Srbija-Hakuje-Koronu/Room-sterilizer/Koristan materijal/94032886_10158607522339924_7840081783709237248_n.jpg

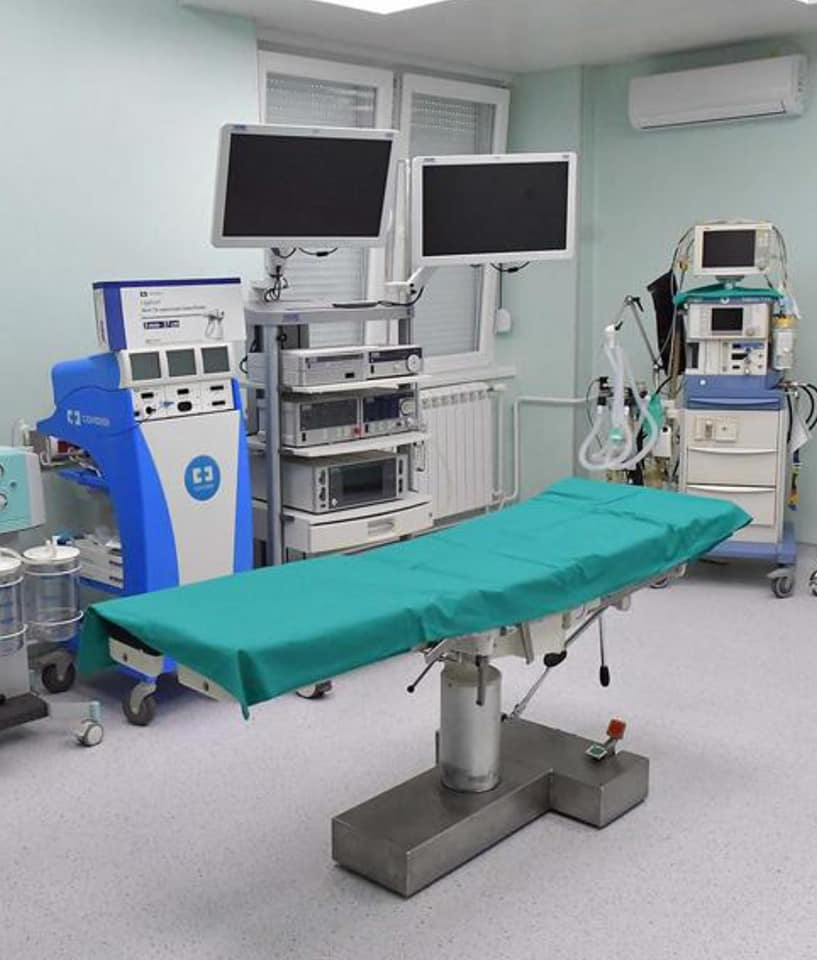
Koristan materijal/94032886_10158607522339924_7840081783709237248_n.jpg
