Srbija-Hakuje-Koronu/Room-sterilizer/Koristan materijal/93118392_10219294678612074_5420074201555927040_o.jpg

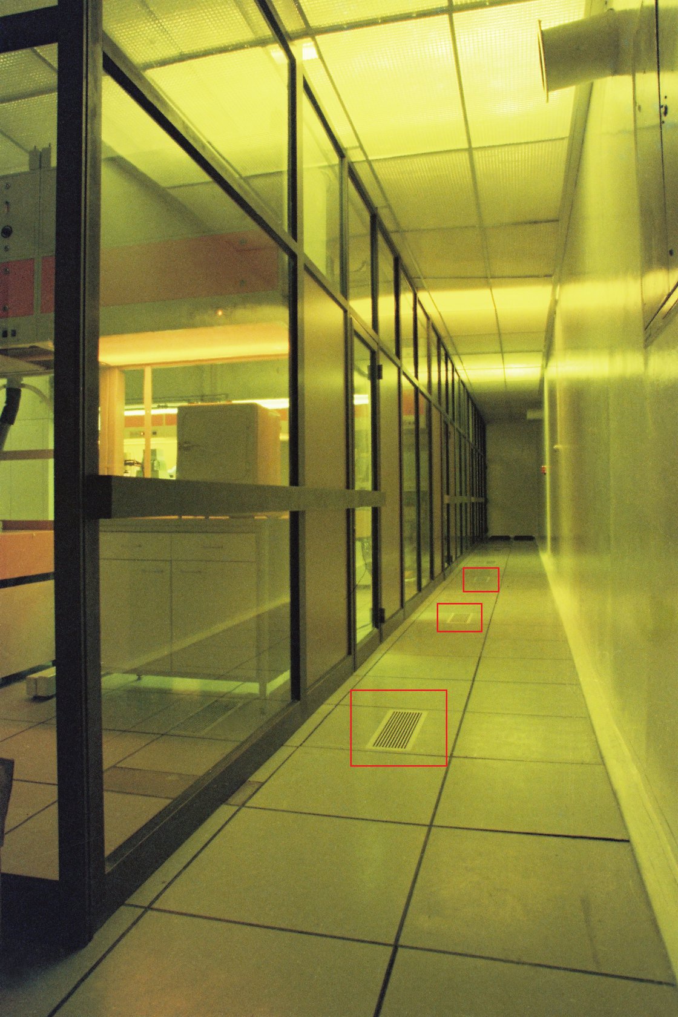
Koristan materijal/93118392_10219294678612074_5420074201555927040_o.jpg
