Srbija-Hakuje-Koronu/Room-sterilizer/Dokumentacija sa crtežima /1591692928066_Dokumentacija za izradu sterilizatora.docx

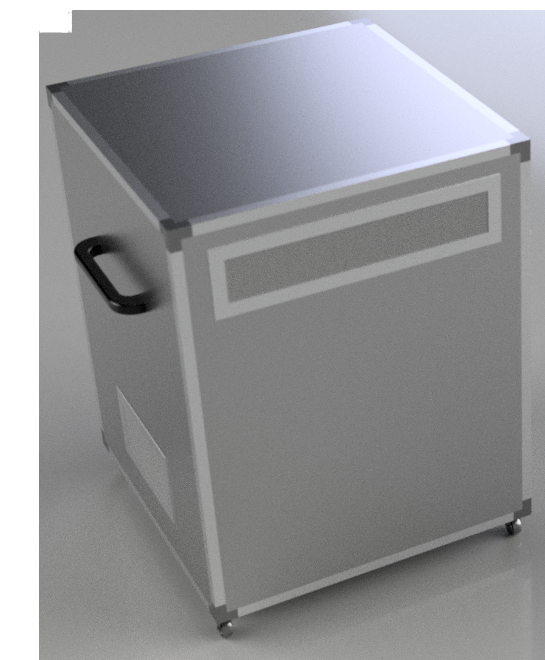
[picture p9: figure]

STERILIZATOR PROSTORIJA

Potreban Materijal:

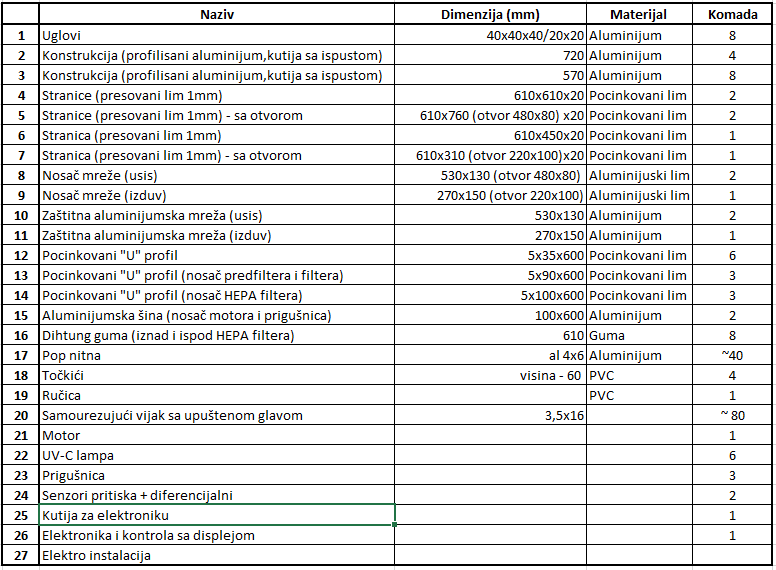
[picture p10: figure]
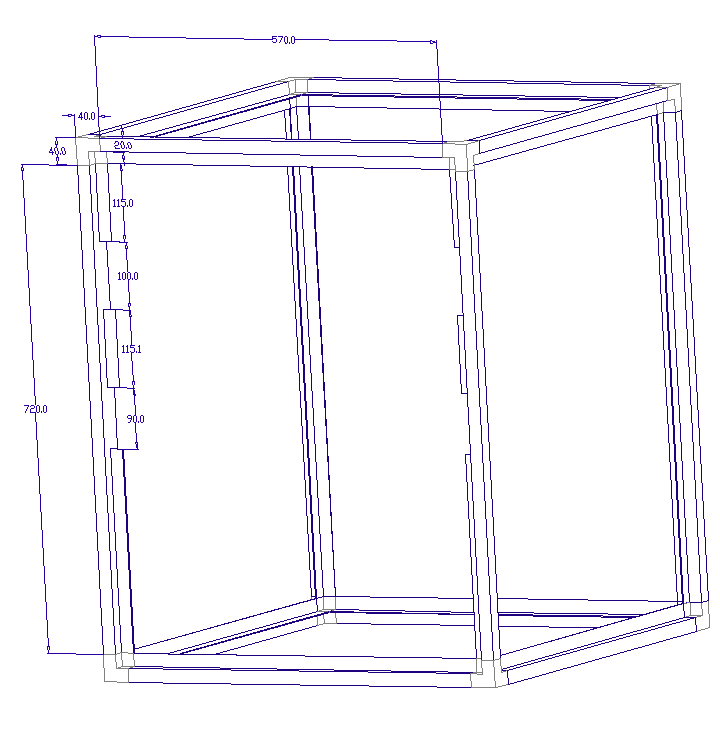
[picture p11: figure]

Uglovi i Konstrukcija (teh.crtež u prilogu PDF „uglovi i konstrukcija):

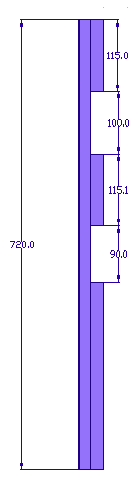
[picture p12: figure]
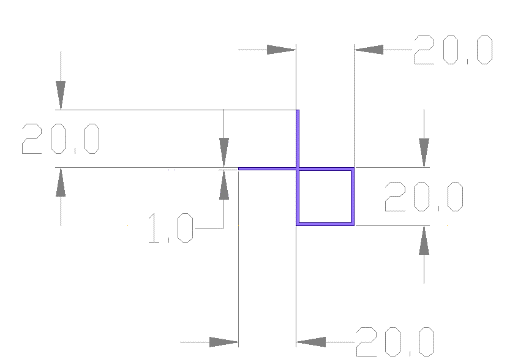
[picture p13: figure]

Izgled Profila konstrukcije:

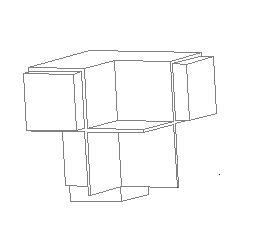
[picture p14: figure]
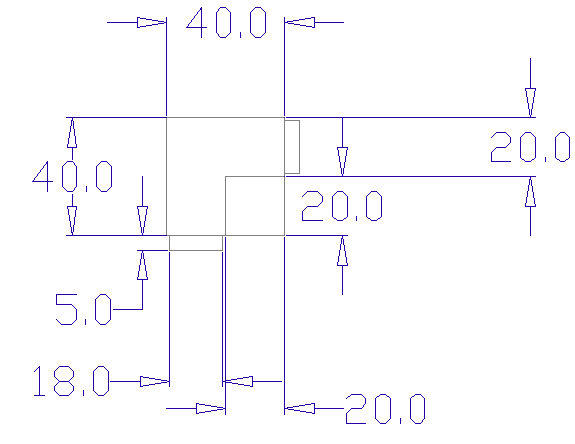
[picture p15: figure]

Izgled uglova:

Iseći po crtežu zbog uvlačenja i izvlačenja filtera na dva stuba.

U profili:

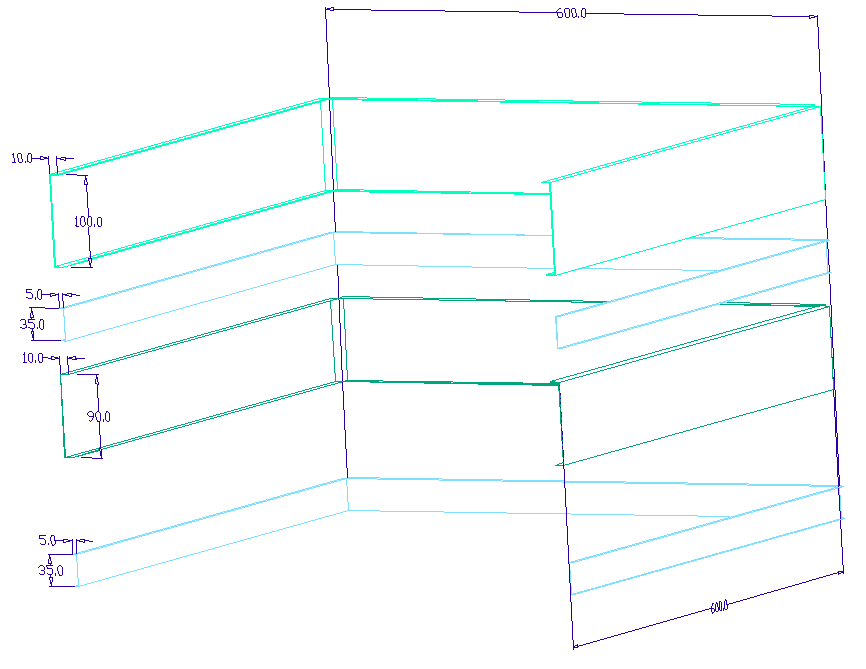
[picture p16: figure]
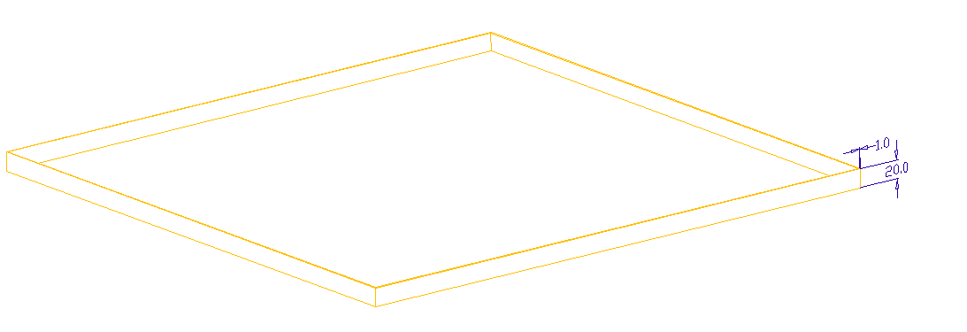
[picture p17: figure]

Stranice presovane kao „tepsija“ (teh.crtež u prilogu PDF „stranice“):

Izolacija (sundjerasta pena sa unutrašnje strane uredjaja zalepljena na sve stranice):

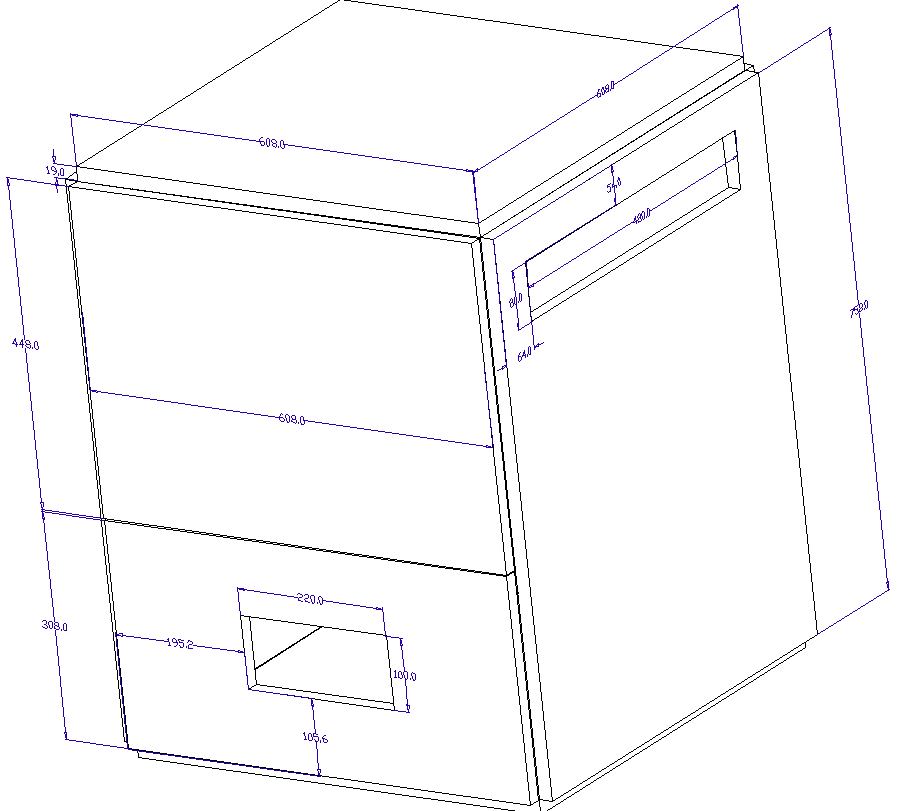
[picture p18: figure]

Vakum guma – preporučeno zalepiti na mestu gde naležu stranice + u gornjoj i donjoj zoni nosača HEPA filtera (na „U“ profilu 100mm) na svim stranama.

Alu - Ukrasni okviri po izboru - koji prekrivaju ulaze i izlaz vazduha postavljeni oko aluminijumske mreže.

Točkići (60mm) – preporučena visina od poda do uredjaja

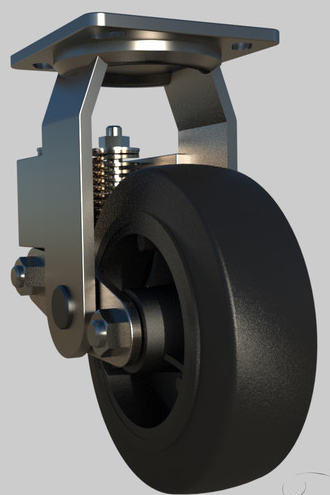
[picture p19: figure]

Drška i mesto za postavku je po izboru na stranici iznad izduva zbog zamene filtera jer se sa te strane izvlače.

Pričvršivanje stranica samourezujućim vijcima na mestima po Vašem izboru kao i postavka pop nitni.
