Srbija-Hakuje-Koronu/Room-sterilizer/Dokumentacija sa crtežima /shk explode.pdf

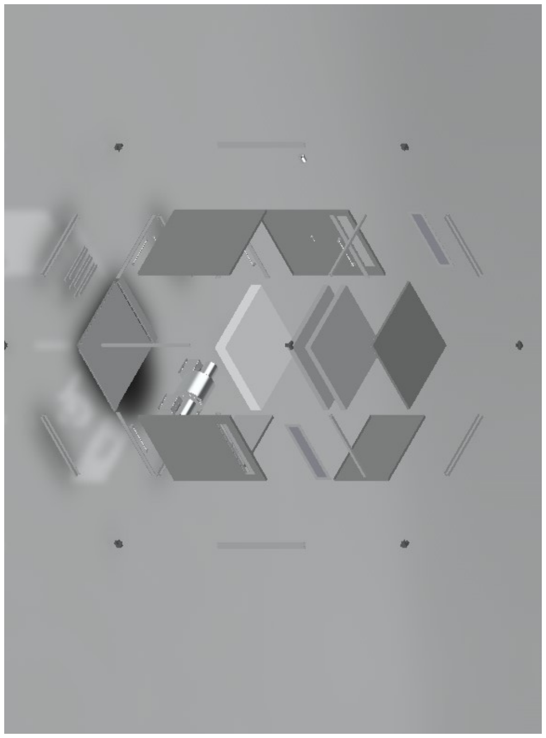
[picture p24: page 1]
