Srbija-Hakuje-Koronu/Room-sterilizer/Dokumentacija sa crtežima /shk presek1.pdf

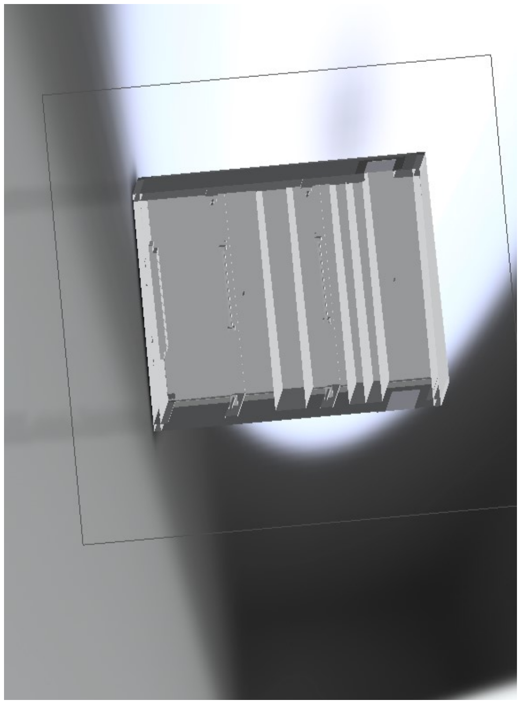
[picture p25: page 1]
