Srbija-Hakuje-Koronu/Room-sterilizer/Dokumentacija sa crtežima /shk presek2.pdf

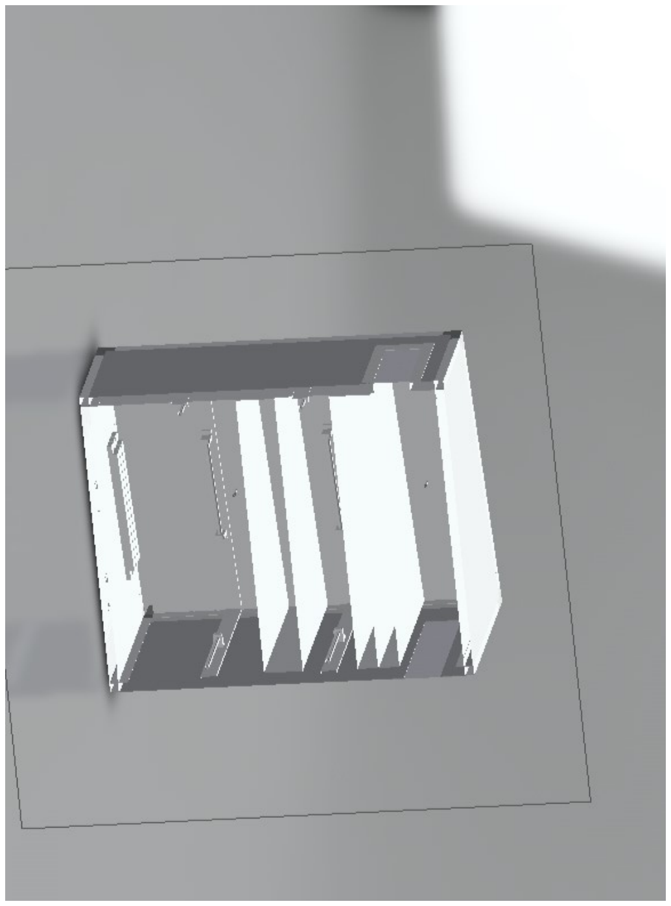
[picture p26: page 1]
