Srbija-Hakuje-Koronu/Room-sterilizer/Dokumentacija projekta/HEPA i predfilteri/HEPA za bioloske lab.jpg

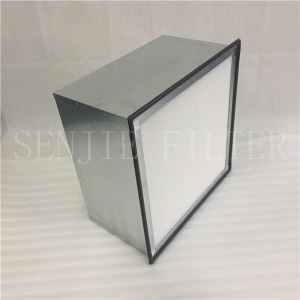
Dokumentacija projekta/HEPA i predfilteri/HEPA za bioloske lab.jpg
