Srbija-Hakuje-Koronu/Room-sterilizer/Dokumentacija projekta/HEPA i predfilteri/hepa-v_f.jpg

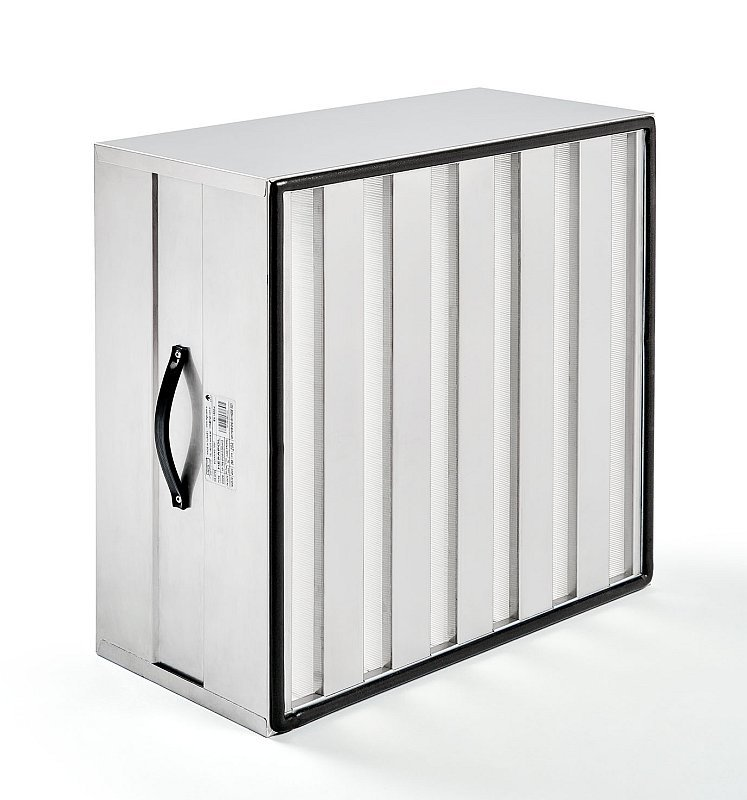
Dokumentacija projekta/HEPA i predfilteri/hepa-v_f.jpg
