Srbija-Hakuje-Koronu/Room-sterilizer/Dokumentacija projekta/HEPA i predfilteri/hepafil-metalni.jpg

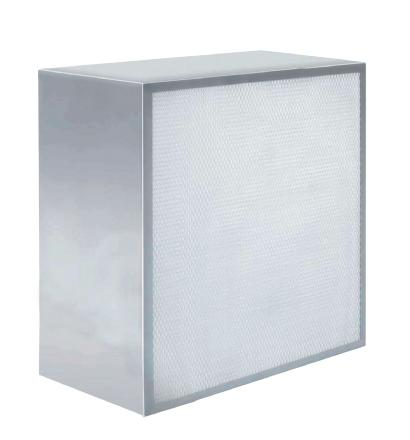
Dokumentacija projekta/HEPA i predfilteri/hepafil-metalni.jpg
