Srbija-Hakuje-Koronu/Room-sterilizer/Dokumentacija projekta/HEPA i predfilteri/hepagel.jpg

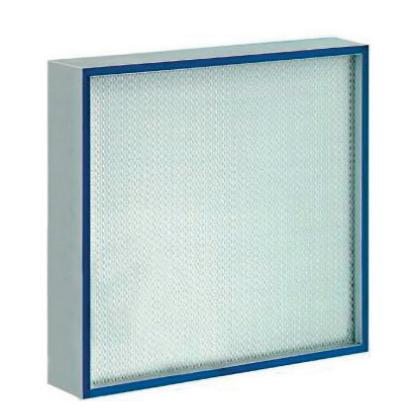
Dokumentacija projekta/HEPA i predfilteri/hepagel.jpg
