Srbija-Hakuje-Koronu/Room-sterilizer/Dokumentacija projekta/HEPA i predfilteri/hepalam-hl.1_f-1.jpg

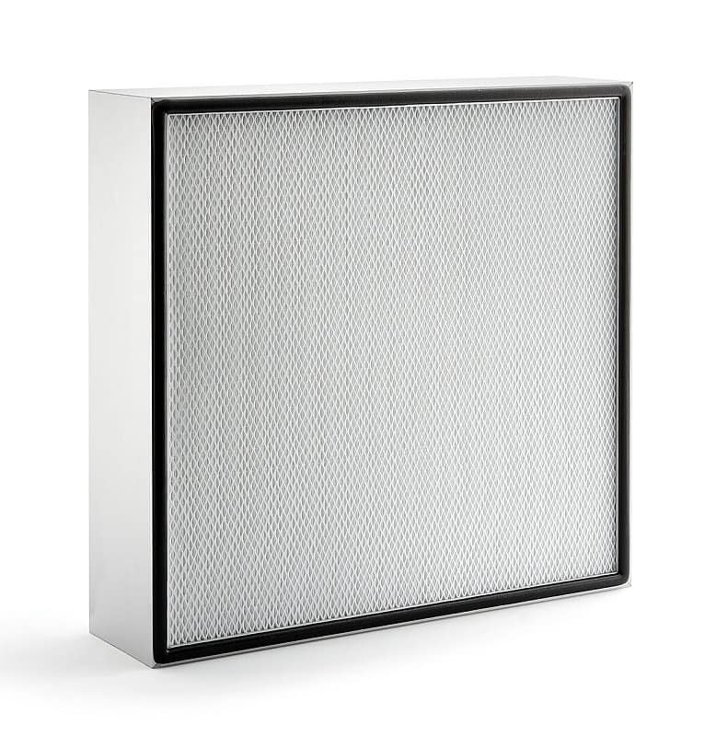
Dokumentacija projekta/HEPA i predfilteri/hepalam-hl.1_f-1.jpg
