Srbija-Hakuje-Koronu/Room-sterilizer/Dokumentacija sa crtežima /Prototip i skice/93203814_117736889889065_6507249180019261440_o.jpg

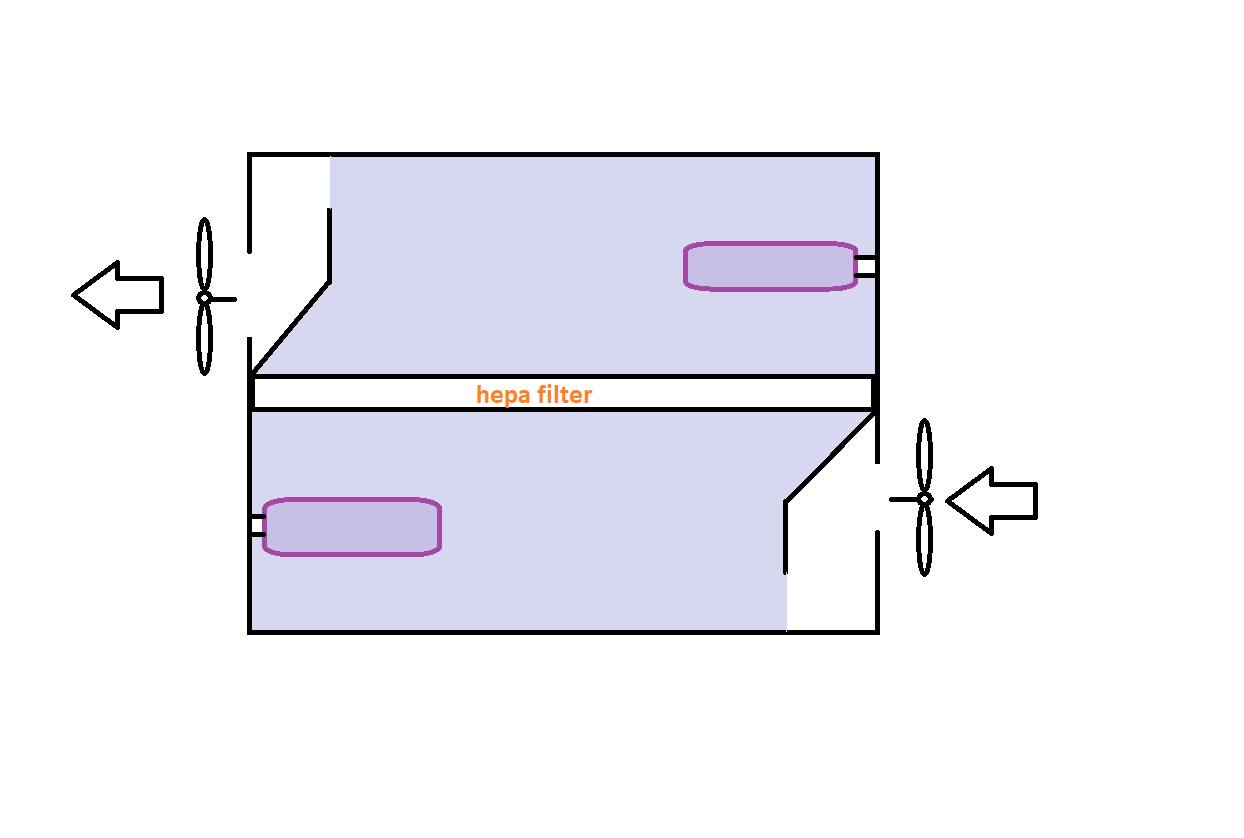
Dokumentacija sa crtežima /Prototip i skice/93203814_117736889889065_6507249180019261440_o.jpg
