Srbija-Hakuje-Koronu/Room-sterilizer/Dokumentacija sa crtežima /Prototip i skice/93551957_10158601676004924_6641523906530246656_o.jpg

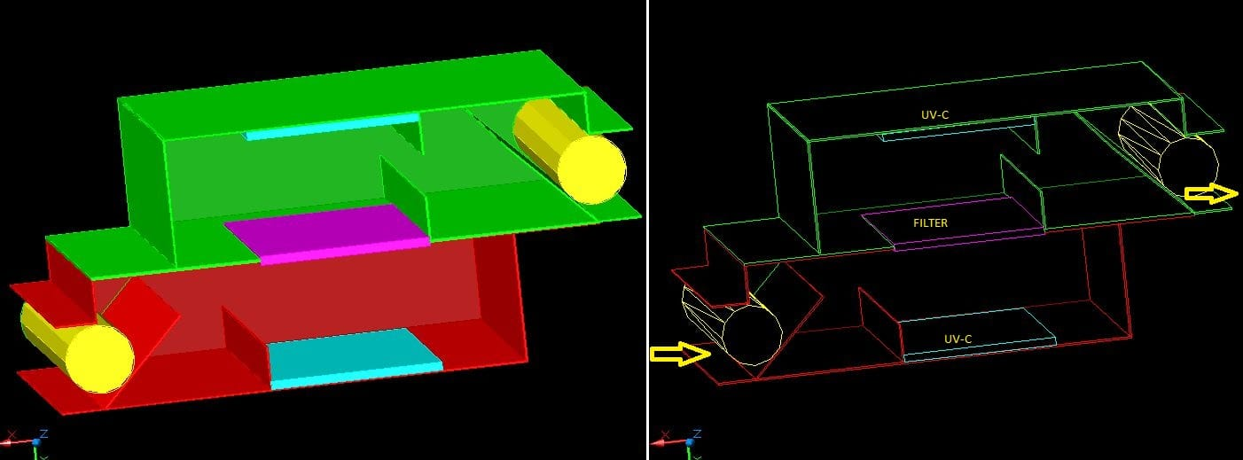
Dokumentacija sa crtežima /Prototip i skice/93551957_10158601676004924_6641523906530246656_o.jpg
