Srbija-Hakuje-Koronu/Room-sterilizer/Dokumentacija sa crtežima /shk_.JPG

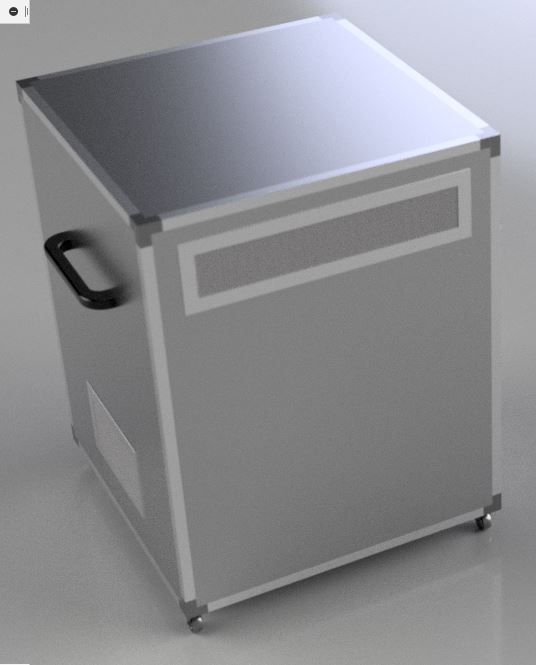
Dokumentacija sa crtežima /shk_.JPG
