Srbija-Hakuje-Koronu/Room-sterilizer/Koristan materijal/92694220_10219294678732077_3626009754347765760_o.jpg

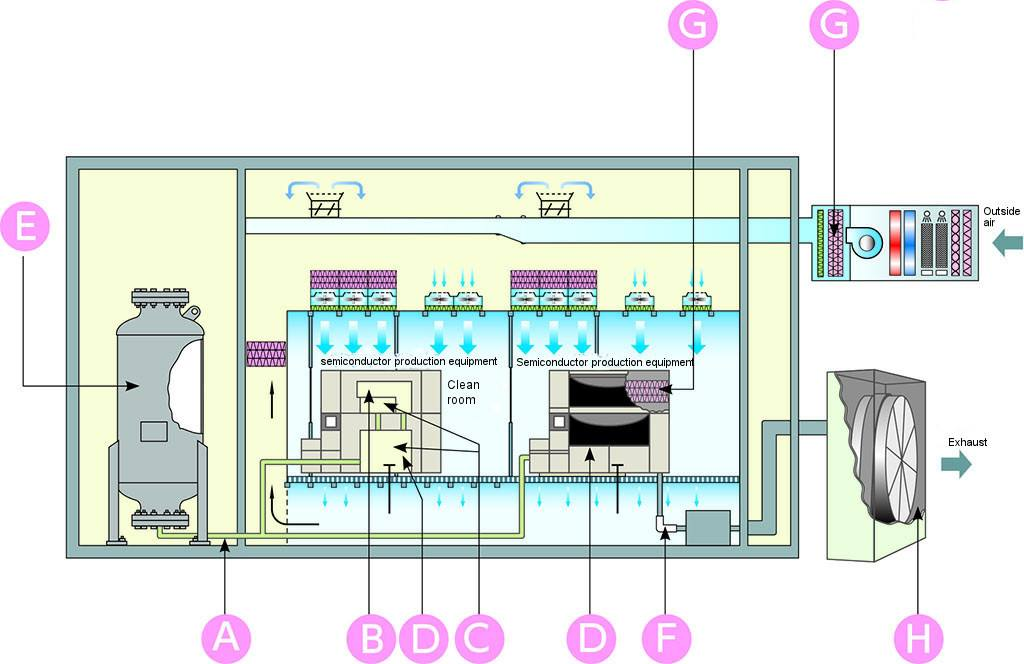
Koristan materijal/92694220_10219294678732077_3626009754347765760_o.jpg
