Srbija-Hakuje-Koronu/Room-sterilizer/Koristan materijal/92735524_539006350346696_5100937309461676032_o.jpg

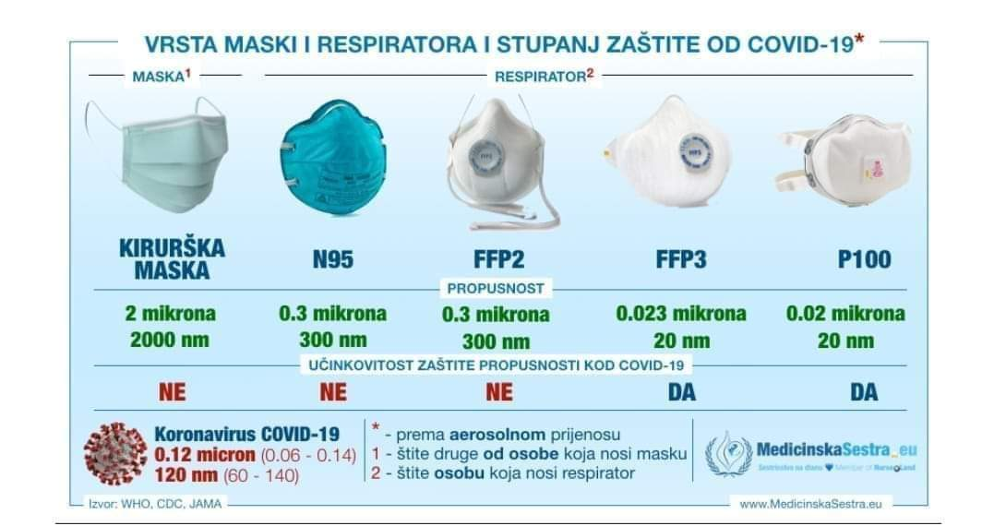
Koristan materijal/92735524_539006350346696_5100937309461676032_o.jpg
