Srbija-Hakuje-Koronu/Room-sterilizer/Koristan materijal/93169904_10219294678412069_1809925310460723200_n.jpg

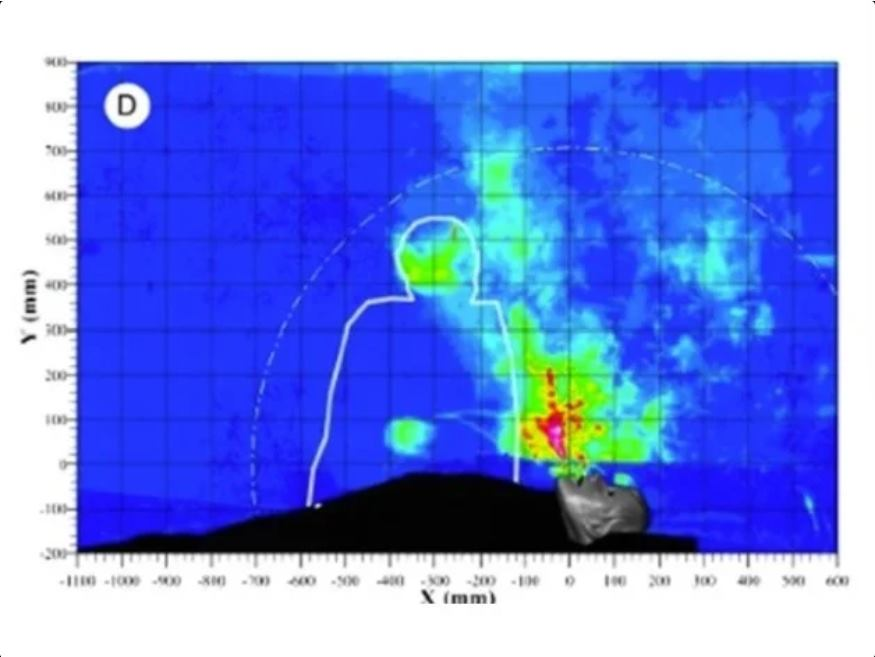
Koristan materijal/93169904_10219294678412069_1809925310460723200_n.jpg
