Srbija-Hakuje-Koronu/Room-sterilizer/Koristan materijal/93381633_10158607522439924_5603166299447361536_n.jpg

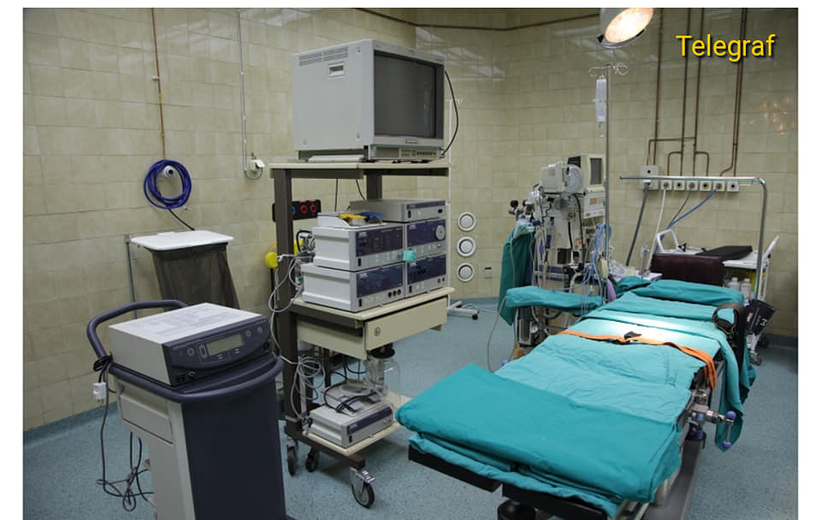
Koristan materijal/93381633_10158607522439924_5603166299447361536_n.jpg
