Srbija-Hakuje-Koronu/Room-sterilizer/Koristan materijal/93620807_10219352169849319_921495747436740608_n.jpg

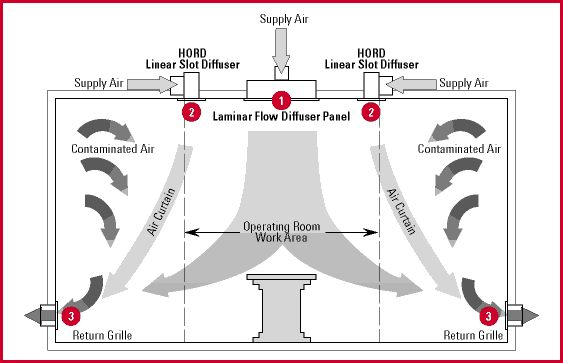
Koristan materijal/93620807_10219352169849319_921495747436740608_n.jpg
