Srbija-Hakuje-Koronu/Room-sterilizer/Dokumentacija projekta/3d modeli/Nosac neonke.stl

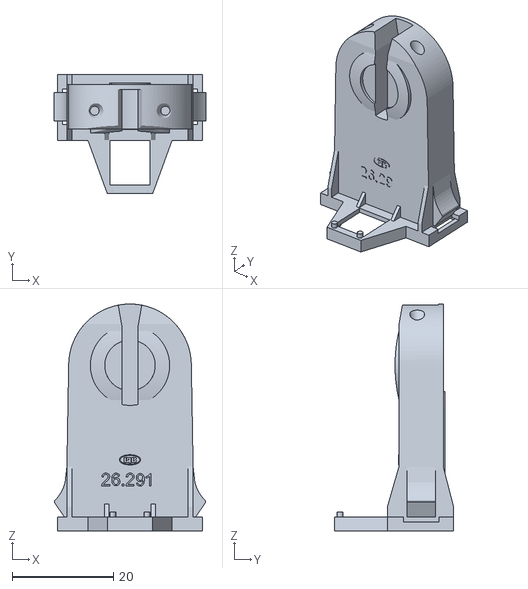
[picture p40: CAD file, 2020-08-03]
Dokumentacija projekta/3d modeli/Nosac neonke.stl
30.0 x 23.6 x 45.0
