Srbija-Hakuje-Koronu/Room-sterilizer/Elektronika - PCB/SHK - sterilizator.STEP

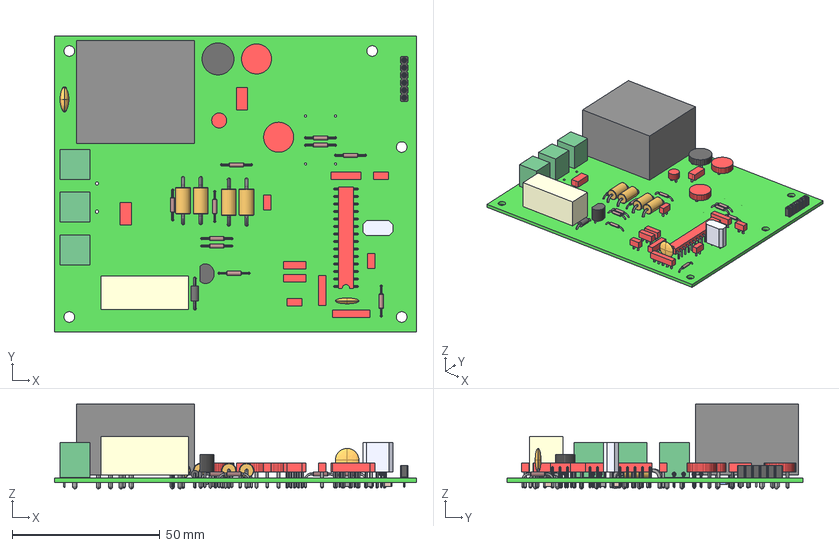
[picture p41: CAD file, 2020-08-03]
Elektronika - PCB/SHK - sterilizator.STEP
122.5 x 100.0 x 28.7 mm
Layer_1
Pin_1 x 46
Pin_2 x 46
Pin_3 x 12
Pin_4 x 7
Pin_5 x 3
Pin_6
Pin_7
Pin_8
Pin_9
Pin_10
Pin_11
Pin_12
Pin_13
Pin_14
Pin_15
Pin_16
Pin_17
Pin_18
Pin_19
Pin_20
Pin_21
Pin_22
Pin_23
Pin_24
Pin_25
Pin_26
Pin_27
Pin_28
