Srbija-Hakuje-Koronu/Room-sterilizer/(list of files, cad)

Other CAD files:
Dokumentacija sa crtežima /Prototip i skice/prototipver4.dwg
Dokumentacija projekta/3d modeli/Nosac neonke.f3d
Dokumentacija sa crtežima /Prototip i skice/prototip v5.f3d
