Srbija-Hakuje-Koronu/Room-sterilizer/Elektronika - PCB/SHK - sterilizator schematic.pdf

BR1

U1

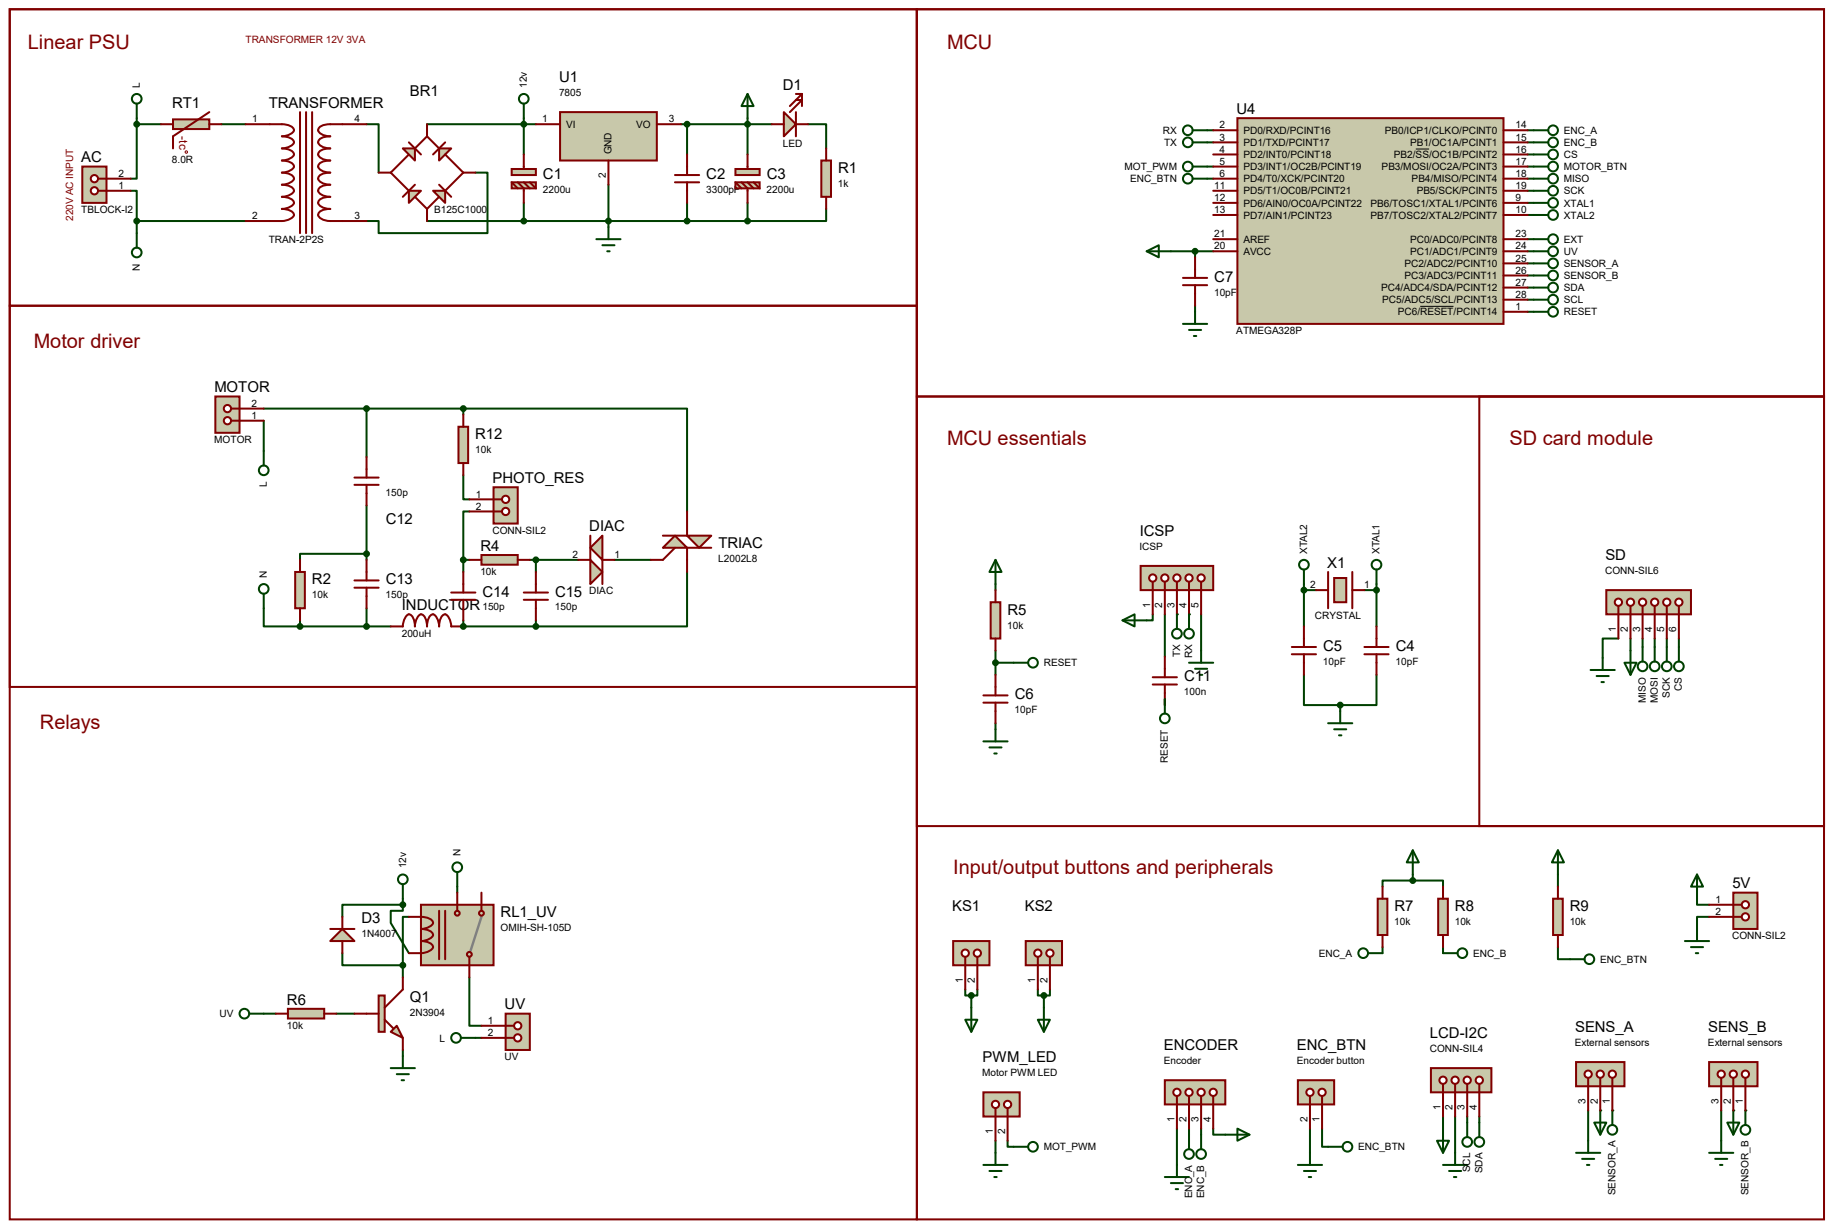
[picture p42: page 1]

Input/output buttons and peripherals
