Srbija-Hakuje-Koronu/Room-sterilizer/Dokumentacija sa crtežima /stranice.pdf

760

800 650 650

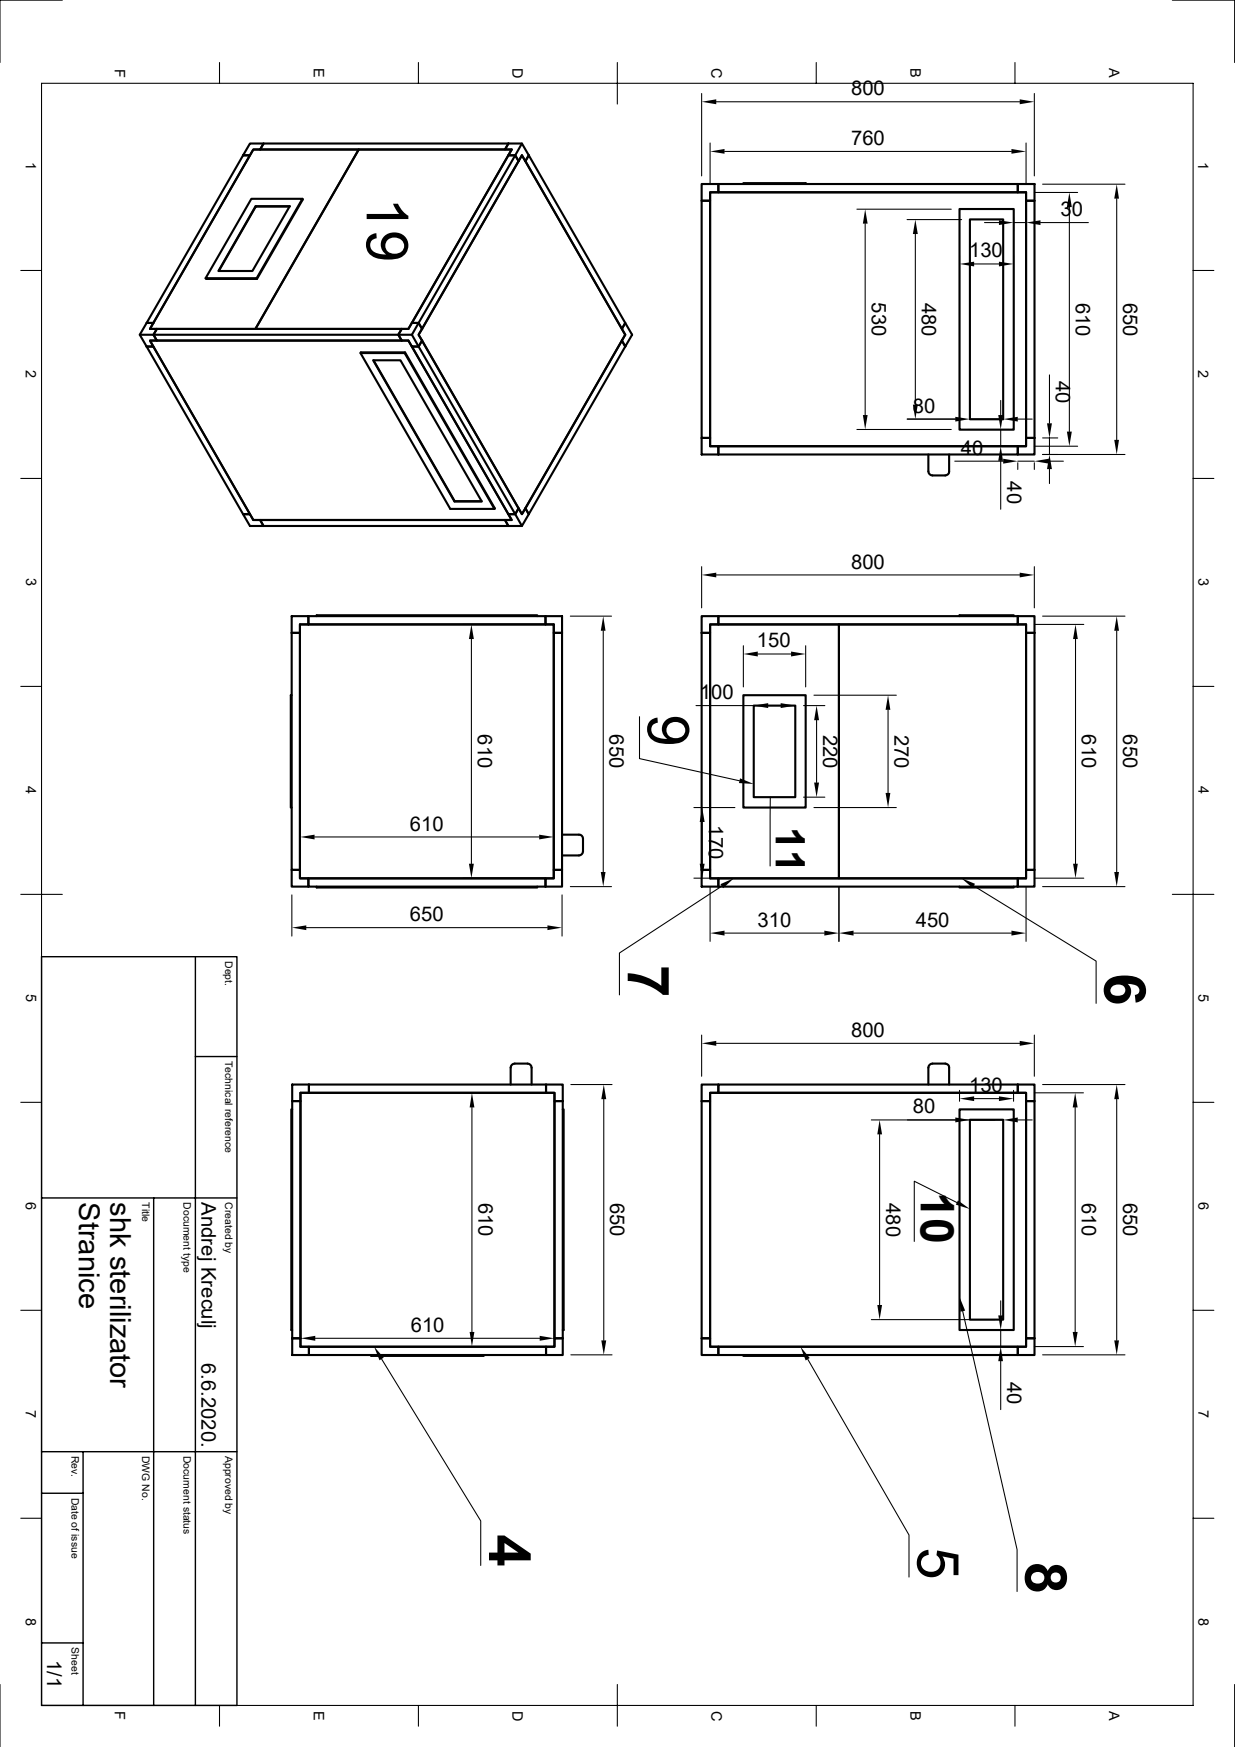
[picture p43: page 1]

1 A 2 3 4 5 6 7 8 1 2 3 4 5 6 7 8 FEDCB FEDCBA Dept. Technical reference Created by Approved by Title DWG No. Document type Document status Rev. Date of issue Sheet 6.6.2020. 1/1 Stranice shk sterilizator Andrej Kreculj 610 610 610
