Srbija-Hakuje-Koronu/Room-sterilizer/Dokumentacija sa crtežima /U profili.pdf

155

300

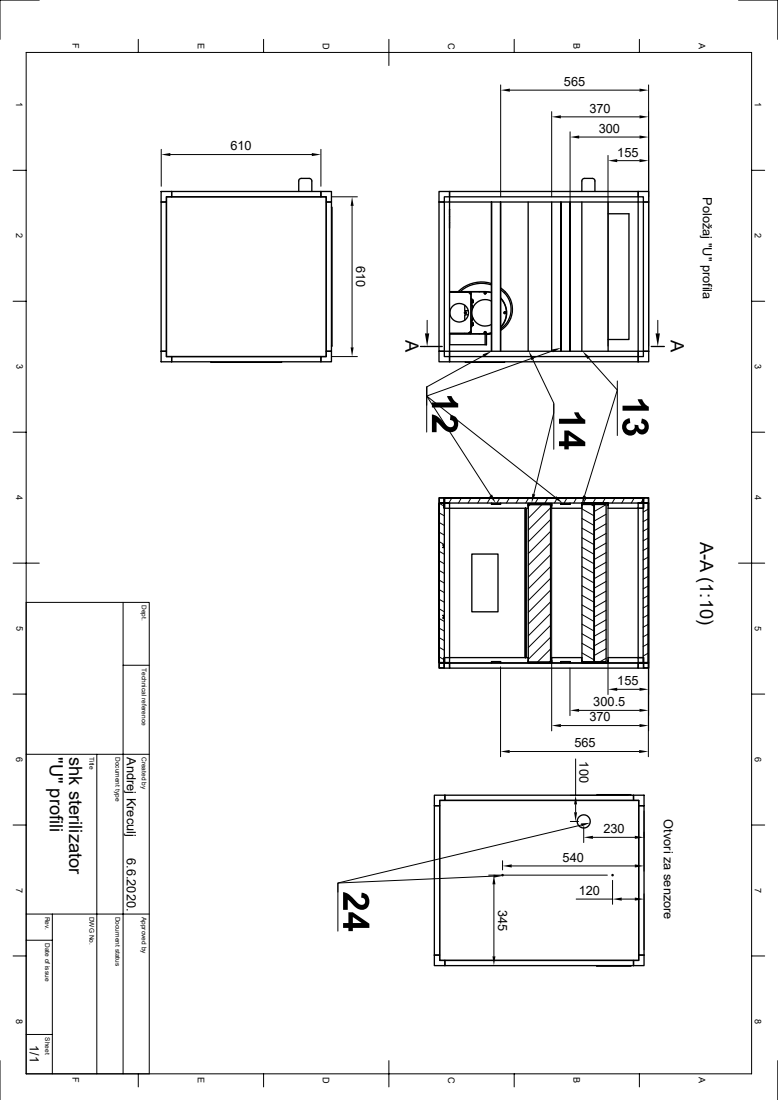
[picture p44: page 1]
230 ¹⁰⁰; Otvori za senzore; Položaj "U" profila 610

1 A 2 3 4 5 6 7 8 1 2 3 4 5 6 7 8 FEDCB FEDCBA Dept. Technical reference Created by Approved by Title DWG No. Document type Document status Rev. Date of issue Sheet 6.6.2020. 1/1 "U" profili shk sterilizator Andrej Kreculj
