Srbija-Hakuje-Koronu/Room-sterilizer/Dokumentacija sa crtežima /uglovi i konstrukcija.pdf

720

90 | 115 | 100 | 115

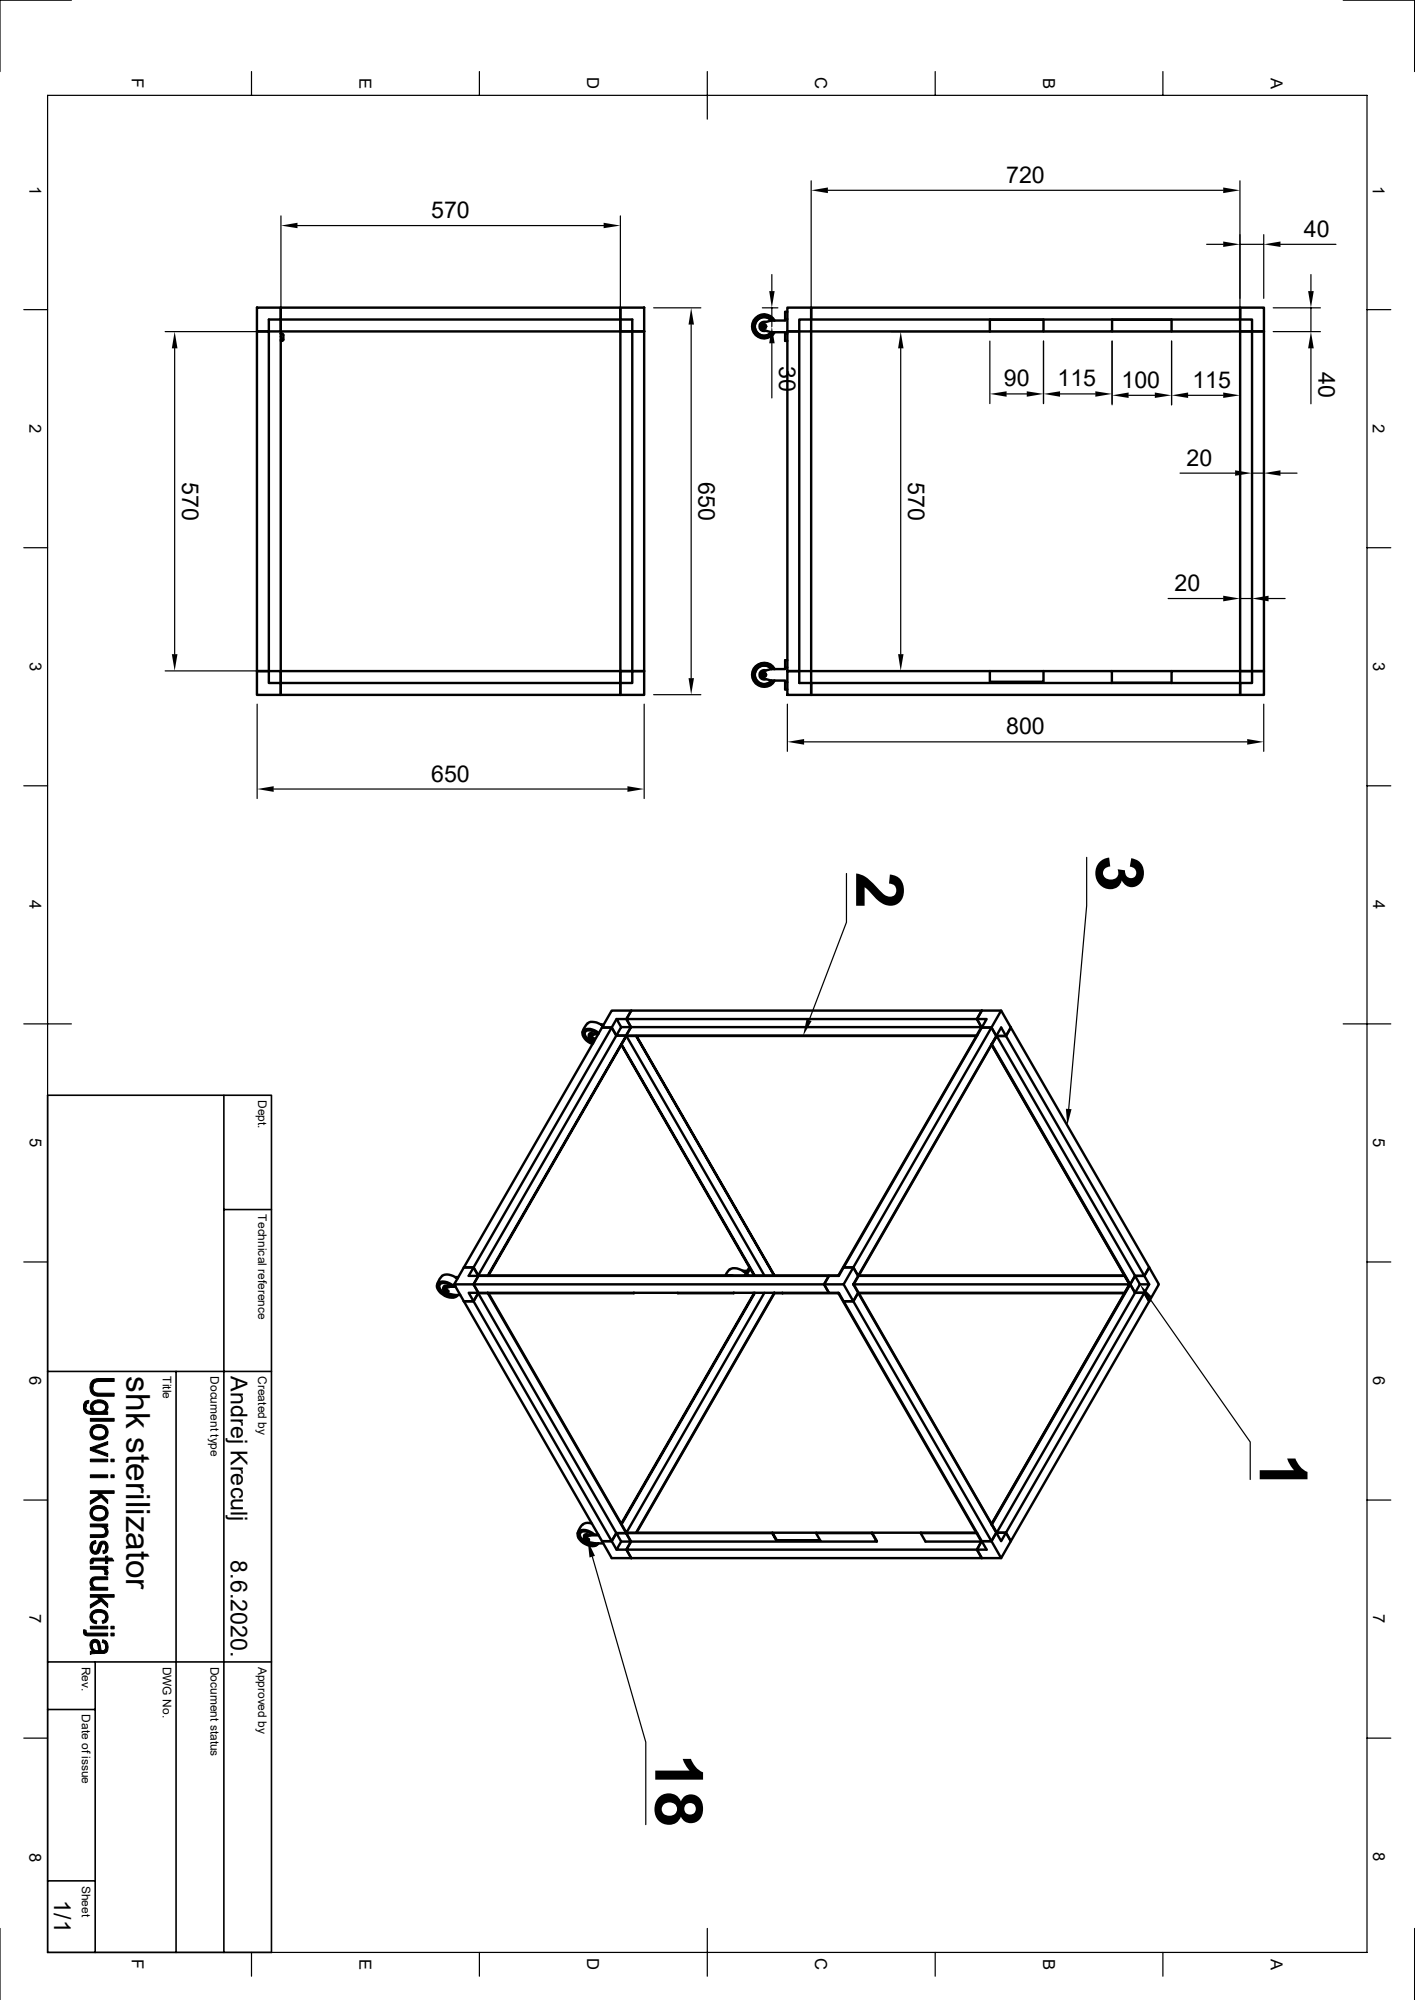
[picture p45: page 1]
20 ⁵⁷⁰ ³⁰

1 A 2 3 4 5 6 7 8 1 2 3 4 5 6 7 8 FEDCB FEDCBA Dept. Technical reference Created by Approved by Title DWG No. Document type Document status Rev. Date of issue Sheet 8.6.2020. 1/1 shk sterilizator Andrej Kreculj
