Srbija-Hakuje-Koronu/Room-sterilizer/Dokumentacija sa crtežima /Prototip i skice/prototipver5-Drawing-v1.pdf

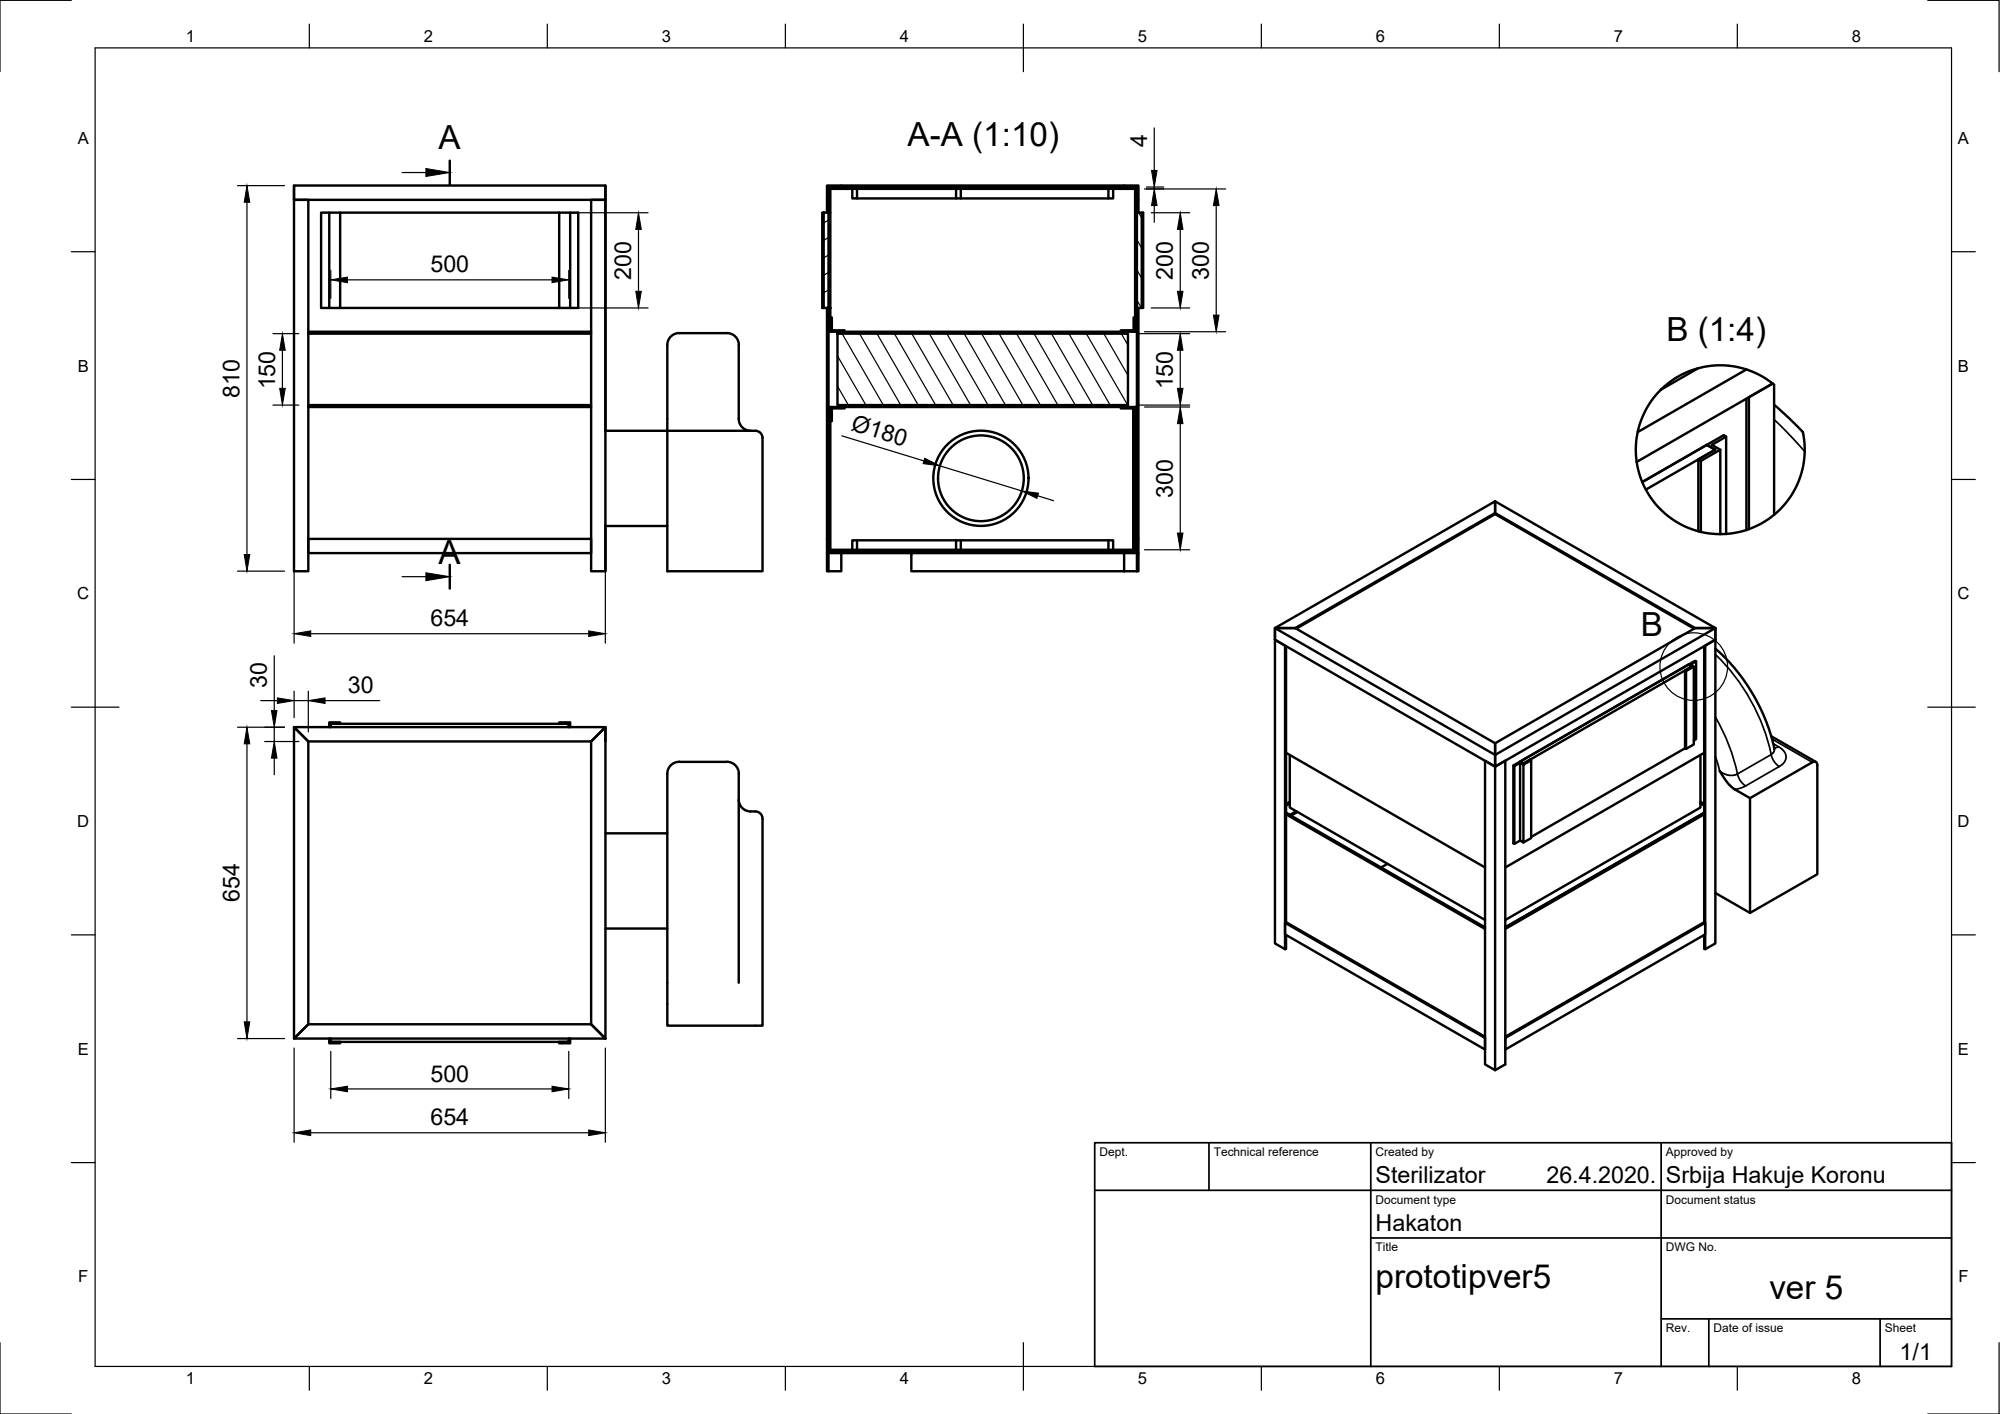
[picture p46: page 1]

Dept. | Technical reference | Created by Sterilizator 26.4.2020. | Approved by Srbija Hakuje Koronu

Document type Hakaton | Document status

Title | DWG No. ver 5 prototipver5

Rev. | Date of issue | Sheet 1/1
