Srbija-Hakuje-Koronu/Room-sterilizer/(list of files, drawings)

Other design files:
Elektronika - PCB/SHK-SterilizatorProstorije.fzz
